xalpol12/pcb-projects/rings-of-saturn-(delay-effect)/reference-files/docs-and-schematics/dm2-delay-schematic.png

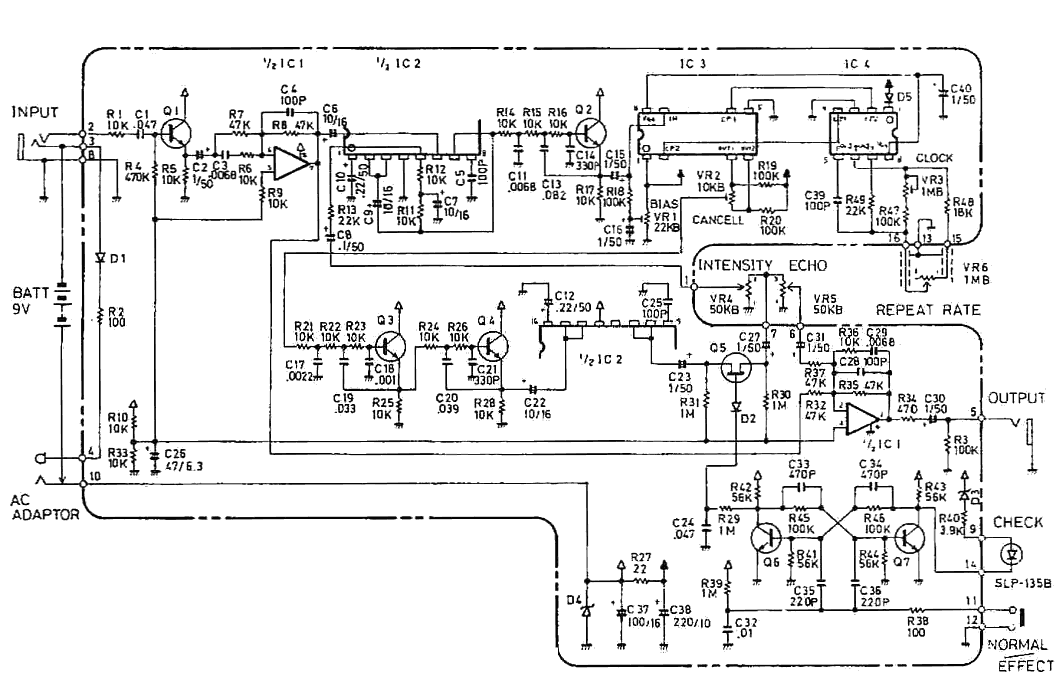
rings-of-saturn-(delay-effect)/reference-files/docs-and-schematics/dm2-delay-schematic.png
