xalpol12/pcb-projects/rings-of-saturn-(delay-effect)/reference-files/docs-and-schematics/pt2399-based/enclosure-dims.jpg

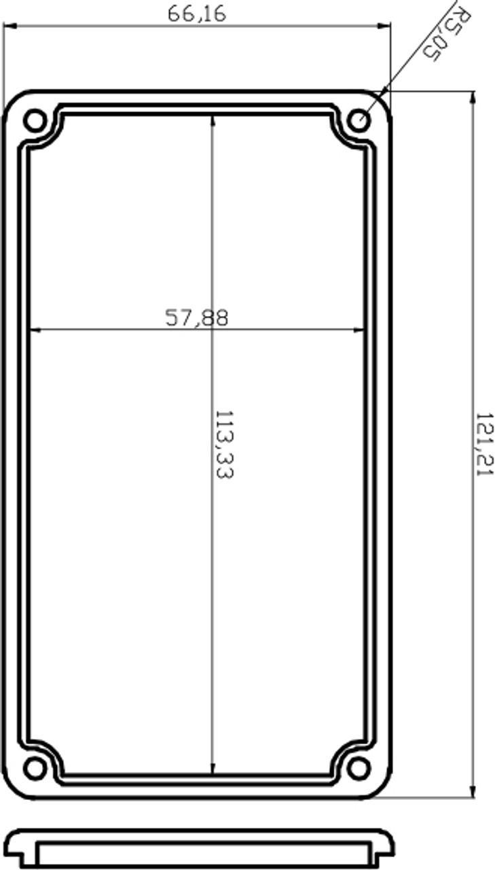
rings-of-saturn-(delay-effect)/reference-files/docs-and-schematics/pt2399-based/enclosure-dims.jpg
