xalpol12/pcb-projects/rings-of-saturn-(delay-effect)/reference-files/boms/components.pdf

Ceramik | typ: 0805
47pF | 1 https://www.mouser.pl/ProductDetail/KEMET/C0805C470J5GACTU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
100pF | 1 https://www.mouser.pl/ProductDetail/Samsung-Electro-Mechanics/CL21C101JBANFNC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
2.2nF | 2 https://www.mouser.pl/ProductDetail/Samsung-Electro-Mechanics/CL21B222KDCNFNC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
4.7nF | 1 https://www.mouser.pl/ProductDetail/Samsung-Electro-Mechanics/CL21B472KBANNNC?qs=349EhDEZ59o6wTs0dQPuJA%3D%3D
10nF | 1 https://www.mouser.pl/ProductDetail/KYOCERA-AVX/KGM21NR71H103KT?qs=Jm2GQyTW%2FbhxygLyzLopYQ%3D%3D
15nF | 1 https://www.mouser.pl/ProductDetail/KEMET/C0805C153K5RACTU?qs=SmE4D0qXCUQDzSI7kMUD0w%3D%3D
22nF | 2 https://www.mouser.pl/ProductDetail/KEMET/C0805C223K5RACTU?qs=u%252BDyEiW6MdDZoRVQfOJ7Ig%3D%3D
47nF | 1 https://www.mouser.pl/ProductDetail/Samsung-Electro-Mechanics/CL21B473KBCNNNC?qs=349EhDEZ59p8vyw6Prguww%3D%3D
100nF | 5 https://www.mouser.pl/ProductDetail/Samsung-Electro-Mechanics/CL21B104MACNNNC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
1uF | 4 https://www.mouser.pl/ProductDetail/Samsung-Electro-Mechanics/CL21B105KOFNNNG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

Elektrolit

10uF | 2 https://www.mouser.pl/ProductDetail/Panasonic/EEE-FK1E100R?qs=qE6bgDGEOCuIB5AxqKF88Q%3D%3D
47uF | 1 https://www.mouser.pl/ProductDetail/Panasonic/EEE-FK1C470P?qs=qE6bgDGEOCuMUCHNT61H1g%3D%3D
100uF | 1 https://www.mouser.pl/ProductDetail/Panasonic/EEE-FK1C101P?qs=qE6bgDGEOCuSC5c%252BLSbo8Q%3D%3D
Rezystory | typ: 0805
33 | 1 https://www.mouser.pl/ProductDetail/SEI-Stackpole/RMCF0805FT33R0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
1k | 2 https://www.mouser.pl/ProductDetail/Bourns/CR0805-FX-1001ELF?qs=sGAEpiMZZMtlubZbdhIBIN4pzcyTCT7wA7XJ11tBTW8%3D
2k | 1 https://www.mouser.pl/ProductDetail/Bourns/CR0805-JW-202ELF?qs=sGAEpiMZZMtlubZbdhIBIPJRFm2x4gVbN1r5EZfhWsg%3D
4k7 | 1 https://www.mouser.pl/ProductDetail/Bourns/CR0805-FX-4701ELF?qs=TYKCbaKwe1AuFEtkTBQjKg%3D%3D
10k | 7 https://www.mouser.pl/ProductDetail/Bourns/CR0805-JW-103ELF?qs=sGAEpiMZZMtlubZbdhIBIBdtMJZUNN5bjlV5FNdlAQE%3D
12k | 1 https://www.mouser.pl/ProductDetail/Bourns/CR0805-FX-1202ELF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
20k | 2 https://www.mouser.pl/ProductDetail/Bourns/CR0805-FX-2002ELF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
22k | 3 https://www.mouser.pl/ProductDetail/Bourns/CR0805-FX-2202ELF?qs=sGAEpiMZZMtlubZbdhIBIKn39ibjI6WbpdK7dVK0xIM%3D

Diody
1n4001 but smd | 1 https://www.mouser.pl/ProductDetail/Diodes-Incorporated/B140Q-13-F?qs=g6T3zOPhKMD%252BzrYmjI9b1A%3D%3D
czerwona | 1 https://www.mouser.pl/ProductDetail/Kingbright/WP7113ID?qs=sGAEpiMZZMusoohG2hS%252B1zuAIIWH1ll4XrjHa4eka9w%3D

Potencjometr
50k - B,vertical | 3 https://www.mouser.pl/ProductDetail/Bourns/PDB12-H4301-503BF?qs=5Cy4ZmKr69mRcO38ZF3X5Q%3D%3D
IC | wszystko SMD
L7805 | 1 https://www.mouser.pl/ProductDetail/STMicroelectronics/L7805CV?qs=9NrABl3fj%2FqplZAHiYUxWg%3D%3D
TL072 | 1 https://www.mouser.pl/ProductDetail/Texas-Instruments/TL072HIDDFR?qs=QNEnbhJQKvb%2F16D9Zb1XRw%3D%3D

PT2399 | 1 | https://www.micros.com.pl/produkt/uipt2399sn,54461.html | https://www.piekarz.pl/38181-uklad-scalony-pmc-components-pt2399-sn-sop16/

Terminal
| 2 pin | 4 | https://www.mouser.pl/ProductDetail/CUI-Devices/TB001-500-02BE?qs=vLWxofP3U2zBBnHgU5u3DA%3D%3D
