xalpol12/pcb-projects/rings-of-saturn-(delay-effect)/reference-files/docs-and-schematics/pt2399-based/delay-project-v1.pdf

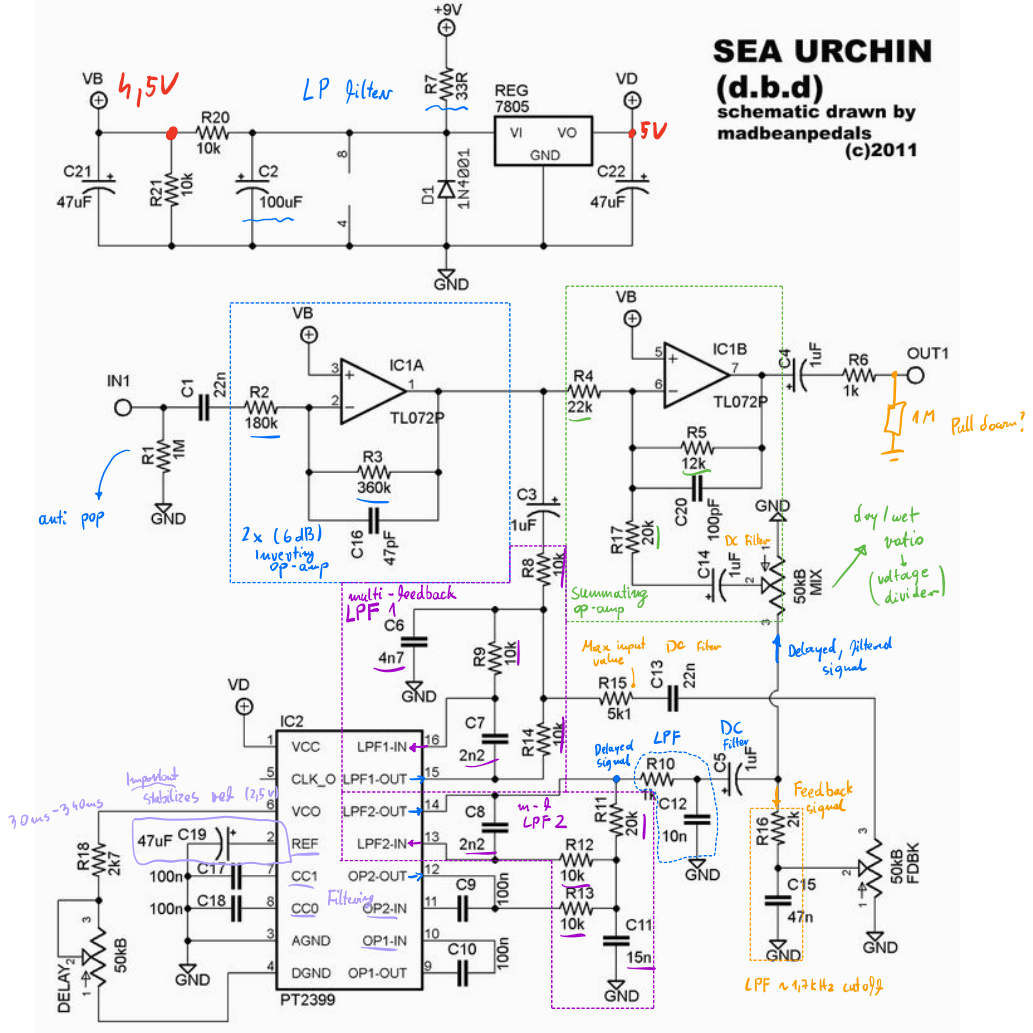
[picture p112: page 1]
