xalpol12/pcb-projects/rings-of-saturn-(delay-effect)/delay.kicad_pcb

## KiCad design rings-of-saturn-(delay-effect)/delay.kicad_pcb (2023-12-11)

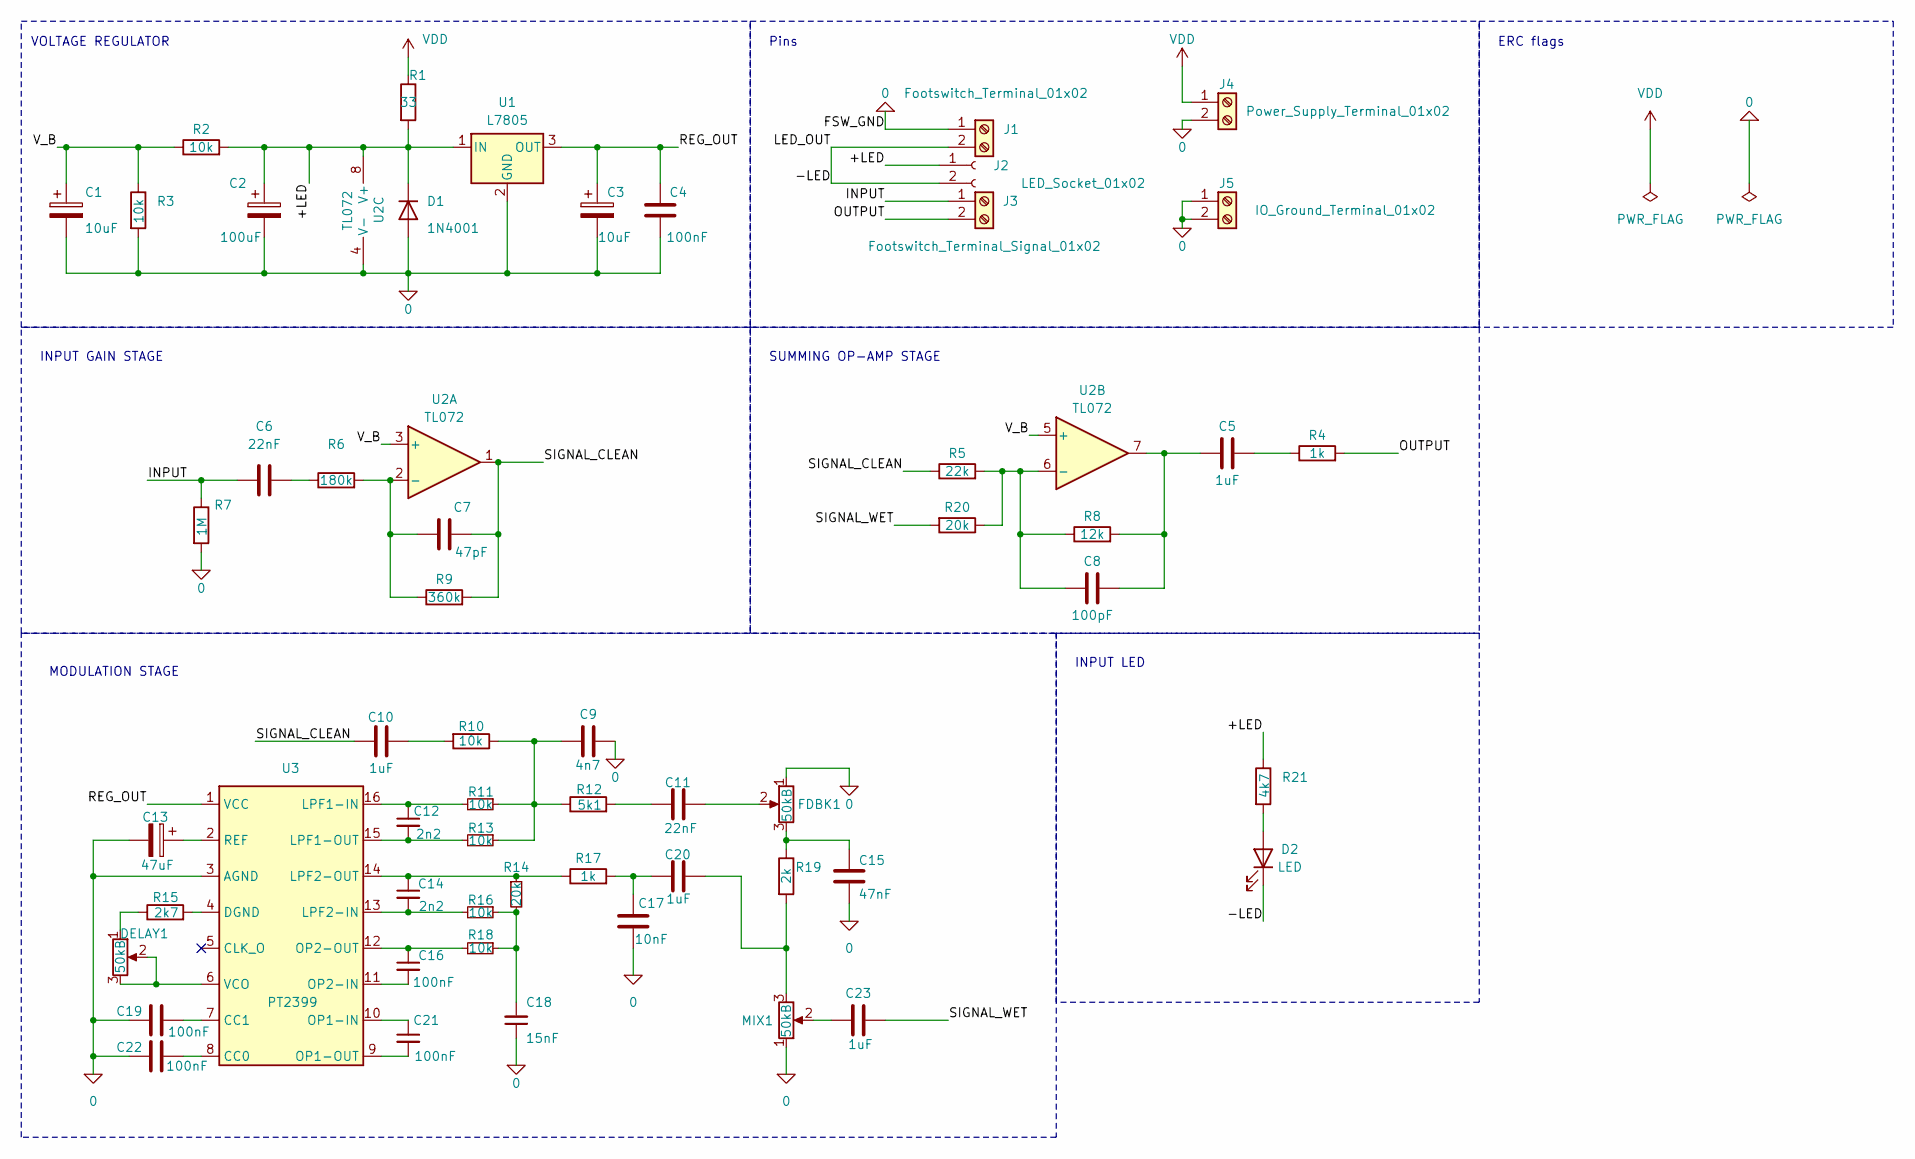
[picture p113: schematic delay.kicad_sch, Delay Guitar Effect]

Parts:
C1, C3: 10uF; EEE1AA220WR
C2: 100uF; EEE1AA101SP
C4, C16, C19, C21, C22: 100nF; C_0805_2012Metric_Pad1.18x1.45mm_HandSolder
C5, C10, C20, C23: 1uF; C_0805_2012Metric_Pad1.18x1.45mm_HandSolder
C6, C11: 22nF; C_0805_2012Metric_Pad1.18x1.45mm_HandSolder
C7: 47pF; C_0805_2012Metric_Pad1.18x1.45mm_HandSolder
C8: 100pF; C_0805_2012Metric_Pad1.18x1.45mm_HandSolder
C9: 4n7; C_0805_2012Metric_Pad1.18x1.45mm_HandSolder
C12, C14: 2n2; C_0805_2012Metric_Pad1.18x1.45mm_HandSolder
C13: 47uF; EEE1AA101SP
C15: 47nF; C_0805_2012Metric_Pad1.18x1.45mm_HandSolder
C17: 10nF; C_0805_2012Metric_Pad1.18x1.45mm_HandSolder
C18: 15nF; C_0805_2012Metric_Pad1.18x1.45mm_HandSolder
D1: 1N4001; DIOM5226X240N
D2: LED; TB00150002BE
DELAY1: 50kB; Potentiometer_Alps_RK163_Single_Horizontal
FDBK1: 50kB; Potentiometer_Alps_RK163_Single_Horizontal
J1: Footswitch_Terminal_01x02; TB00150002BE
J2: LED_Socket_01x02; TB00150002BE
J3: Footswitch_Terminal_Signal_01x02; TB00150002BE
J4: Power_Supply_Terminal_01x02; TB00150002BE
J5: IO_Ground_Terminal_01x02; TB00150002BE
MIX1: 50kB; Potentiometer_Alps_RK163_Single_Horizontal
R1: 33; R_0805_2012Metric_Pad1.20x1.40mm_HandSolder
R2, R3, R10, R11, R13, R16, R18: 10k; R_0805_2012Metric_Pad1.20x1.40mm_HandSolder
R4, R17: 1k; R_0805_2012Metric_Pad1.20x1.40mm_HandSolder
R5: 22k; R_0805_2012Metric_Pad1.20x1.40mm_HandSolder
R6: 180k; R_0805_2012Metric_Pad1.20x1.40mm_HandSolder
R7: 1M; R_0805_2012Metric_Pad1.20x1.40mm_HandSolder
R8: 12k; R_0805_2012Metric_Pad1.20x1.40mm_HandSolder
R9: 360k; R_0805_2012Metric_Pad1.20x1.40mm_HandSolder
R12: 5k1; R_0805_2012Metric_Pad1.20x1.40mm_HandSolder
R14, R20: 20k; R_0805_2012Metric_Pad1.20x1.40mm_HandSolder
R15: 2k7; R_0805_2012Metric_Pad1.20x1.40mm_HandSolder
R19: 2k; R_0805_2012Metric_Pad1.20x1.40mm_HandSolder
R21: 4k7; R_0805_2012Metric_Pad1.20x1.40mm_HandSolder
U1: L7805; L7805CD2T
U2: TL072; SOT65P280X110-8N
U3: PT2399; SOIC-16_3.9x9.9mm_P1.27mm

Connections:
0: C1.2, C2.2, C3.2, C4.2, C9.2, C13.2, C15.2, C17.1, C18.1, C19.2, C22.2, D1.2 (A), FDBK1.1, J1.1, J4.2, J5.1, J5.2, MIX1.1, R3.2, R7.2, U1.2 (GND), U2.4 (V-), U3.3 (AGND)
/+LED: C2.1, D1.1 (K), J2.1, R1.2, R2.2, R21.1, U1.1 (IN), U2.8 (V+)
/-LED: D2.1 (K), J1.2, J2.2
/INPUT: C6.1, J3.1, R7.1
/OUTPUT: J3.2, R4.2
/REG_OUT: C3.1, C4.1, U1.3 (OUT), U3.1 (VCC)
/SIGNAL_CLEAN: C7.2, C10.2, R5.1, R9.2, U2.1
/SIGNAL_WET: C23.2, R20.2
/V_B: C1.1, R2.1, R3.1, U2.3 (+), U2.5 (+)
unnamed: C5.1, C8.2, R8.2, U2.7
unnamed: C5.2, R4.1
unnamed: C6.2, R6.1
unnamed: C9.1, R10.1, R11.1, R12.1, R13.1
unnamed: C10.1, R10.2
unnamed: C11.1, R12.2
unnamed: C11.2, FDBK1.2
unnamed: C15.1, FDBK1.3, R19.1
unnamed: C17.2, C20.1, R17.2
unnamed: C18.2, R14.2, R16.1, R18.1
unnamed: C20.2, MIX1.3, R19.2
unnamed: C23.1, MIX1.2
unnamed: D2.2 (A), R21.2
unnamed: DELAY1.1, R15.1
unnamed: C7.1, R6.2, R9.1, U2.2 (-)
unnamed: C8.1, R5.2, R8.1, R20.1, U2.6 (-)
unnamed: C22.1, U3.8 (CC0)
unnamed: C19.1, U3.7 (CC1)
unnamed: R15.2, U3.4 (DGND)
unnamed: C12.1, R11.2, U3.16 (LPF1-IN)
unnamed: C12.2, R13.2, U3.15 (LPF1-OUT)
unnamed: C14.2, R16.2, U3.13 (LPF2-IN)
unnamed: C14.1, R14.1, R17.1, U3.14 (LPF2-OUT)
unnamed: C21.1, U3.10 (OP1-IN)
unnamed: C21.2, U3.9 (OP1-OUT)
unnamed: C16.2, U3.11 (OP2-IN)
unnamed: C16.1, R18.2, U3.12 (OP2-OUT)
unnamed: C13.1, U3.2 (REF)
unnamed: DELAY1.2, DELAY1.3, U3.6 (VCO)
VDD: J4.1, R1.1

Notes on the sheet:
ERC flags
MODULATION STAGE
SUMMING OP-AMP STAGE
INPUT LED
INPUT GAIN STAGE
Pins
VOLTAGE REGULATOR

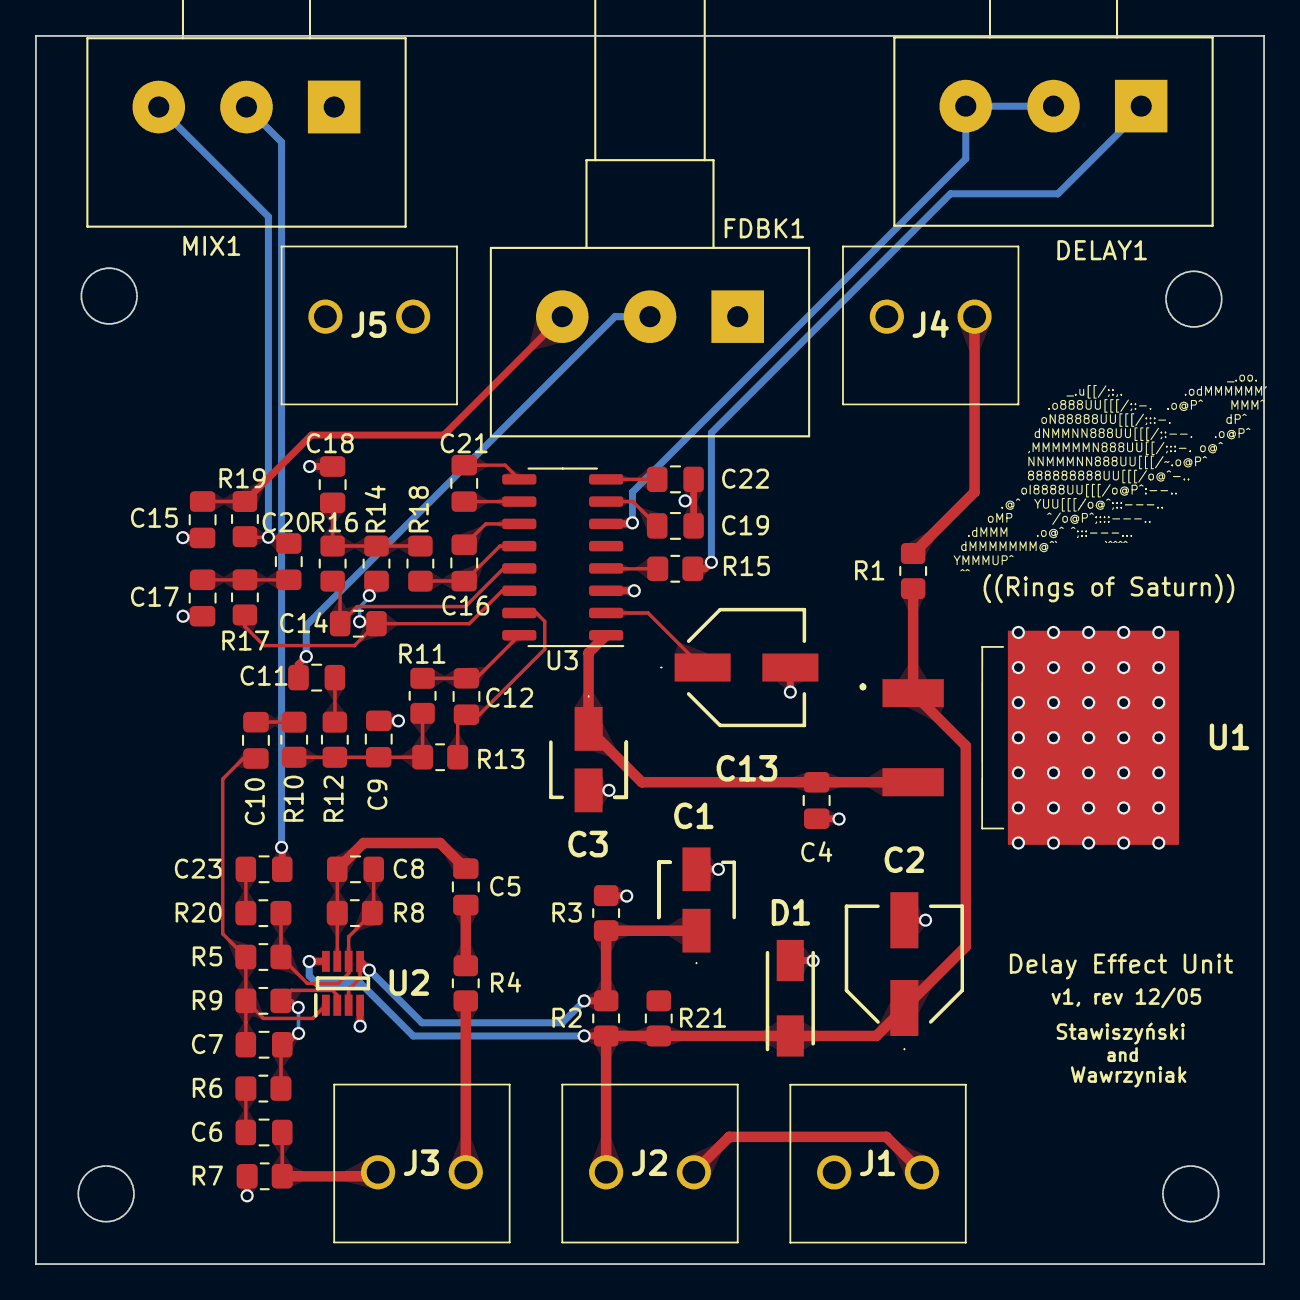
[picture p114: board delay.kicad_pcb from above]

Board: 2 copper layers, 70.0 x 70.0 mm, 56 parts (0 on the bottom side), 38 nets.
