xalpol12/pcb-projects/(commit log)

2023-11-06 add ref materials
2023-11-06 add footprint for each element
    [delay.kicad_sch]
2023-11-07 add list of components and respective links, add real footprints
    [components.xlsx, delay.kicad_sch]
2023-11-10 add screw connectors
    [delay.kicad_sch]
2023-11-11 update design rules for pcb creator to match requirements
    [delay.kicad_pcb, delay.kicad_sch]
2023-11-13 add remaining footprints, start pcb design process
    [components.ods, components.xlsx, delay.kicad_pcb, delay.kicad_sch]
2023-11-15 create preliminary pcb spacing design
    [delay.kicad_pcb]
2023-11-15 add some connections (first draw)
    [delay.kicad_pcb, delay.kicad_sch]
2023-11-19 update pcb design schema
    [delay.kicad_pcb]
2023-11-19 create preliminary design schema with internal connections
    [delay.kicad_pcb]
2023-11-20 create connections for all signals except 0
    [delay.kicad_pcb, delay.kicad_sch]
2023-11-20 connect mass and reorganise labels
    [delay.kicad_pcb]
2023-11-21 modify ground layer positioning
    [delay.kicad_pcb]
2023-11-22 update pcb design
    [delay.kicad_pcb]
2023-11-24 add ground vias inside stabilisator GND field, add board revision info
    [delay.kicad_pcb, delay.kicad_sch]
2023-12-04 improve ground plane design, add thicker routes to audio paths
    [delay.kicad_pcb]
2023-12-04 refactor pcb design, reduce board size to 70x70
    [delay.kicad_pcb]
2023-12-05 add pcb mounting holes
    [delay.kicad_pcb]
2023-12-05 small track thickness and area keepout adjustments
    [delay.kicad_pcb]
2023-12-06 fine tune ground vias distance from components
    [delay.kicad_pcb]
2023-12-07 create subfolder for ring of saturn project
    [components.ods, delay.kicad_pcb, delay.kicad_sch]
2023-12-11 add .gitignore with backup files
    [components.ods, delay.kicad_pcb, delay.kicad_sch]
2023-12-11 reset file tracking for rings-of-saturn directory
    [components.ods, delay.kicad_pcb, delay.kicad_sch]
2023-12-17 init fuzz-effect project (based on big muff guitar pedal)
    [fuzz-effect.kicad_pcb, fuzz-effect.kicad_sch]
2023-12-18 fuzz effect first schematic draft, add reference files
    [fuzz-effect.kicad_pcb, fuzz-effect.kicad_sch]
