xalpol12/pcb-projects/(notices)

Notices in the files:
rings-of-saturn-(delay-effect)/reference-files/docs-and-schematics/Coda Effects - How to build your first DIY guitar pedal (step by step tutorial).html:
Theme License : This free Blogger template is licensed under the Creative Commons Attribution 3.0 License, which permits both personal and commercial use.
However, to satisfy the &#39;attribution&#39; clause of the license, you are required to keep the footer links intact which provides due credit to its authors. For more specific details about the license, you may visit the URL below:
http://creativecommons.org/licenses/by/3.0
